kadash12/Altium-MPLAB-Senior/Beacon.jpg

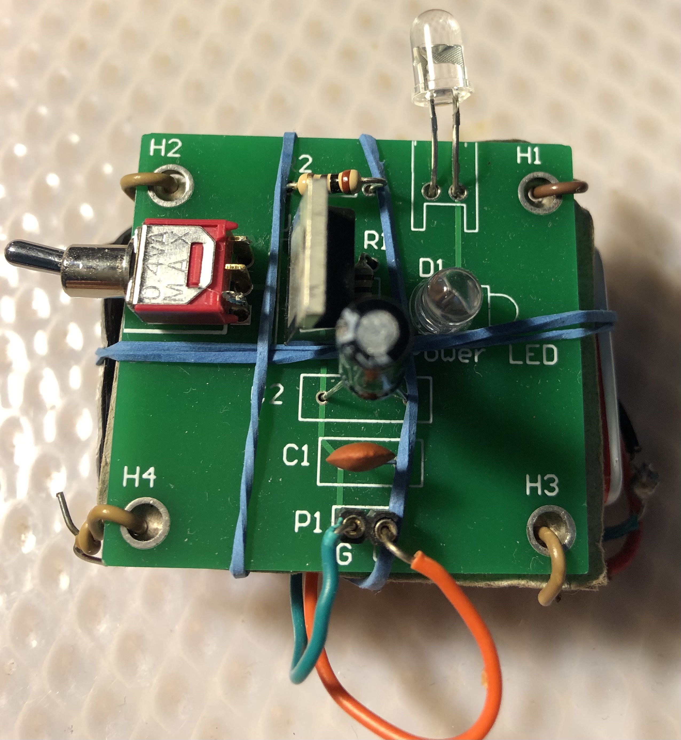
Beacon.jpg
