kadash12/Altium-MPLAB-Senior/L298N.jpg

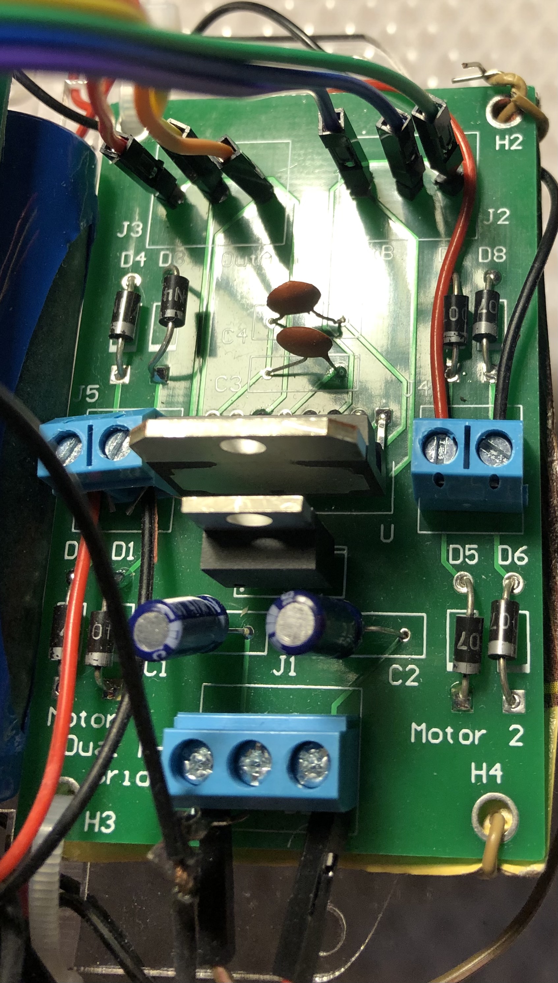
L298N.jpg
