kadash12/Altium-MPLAB-Senior/Project Presentation.pptx

## EEL 4914 Senior Design Project Presentation Title: Car Insight Submitted by: Johnny Li Advisory Engineer: Zane P Zudans

## Introduction

- Build a battery powered autonomous robotic car.
  - Platform for testing proximity detection and collision avoidance.
  - Use AI to solve a maze and then reverse to use the most optimal path back out.
- Problem: To ensure passenger and public safety in autonomous cars.
- What is out there already?
  - Integrated into many cars: Tesla, Waymo, and GM Cruise.
  - Vehicle sensors: Camera, Radar, and Lidar.
  - Ultrasonic sensors, traditionally associated with parking.
- LED, Speaker, Digital features (LCD, Timer)

## Project Description + Hardware

- Ultrasonic object detection
- Mount on servo to provide 180°
- Battery Power at ~5V
- LCD screen
- LEDs and speaker
- Gear motor to control movement
- PIC18F45Q10 Microcontroller:
  - 2 x I2C/SPI, 8-bit timer, PWM
Dual channel H bridge motor driver

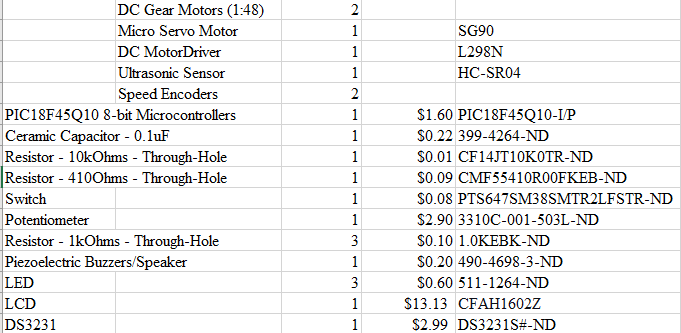
[picture p3: figure]
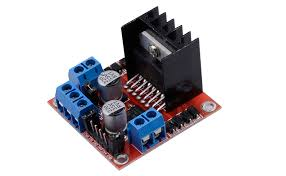
[picture p4: figure]
Qunqi L298N Motor Drive Controller Board Module Dual H Bridge DC Stepper For Arduino - - Amazon.com

HC-SR04

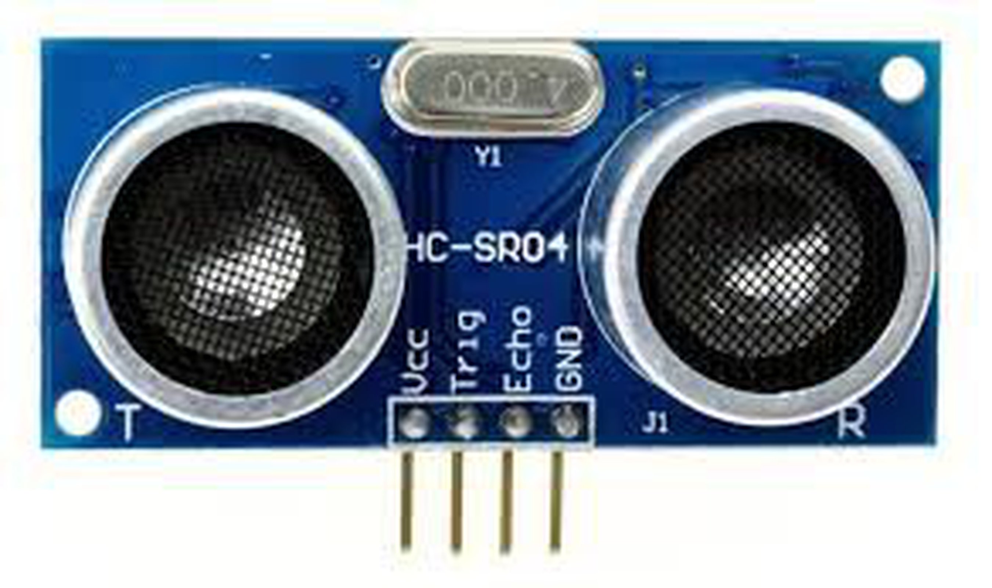
[picture p5: figure]
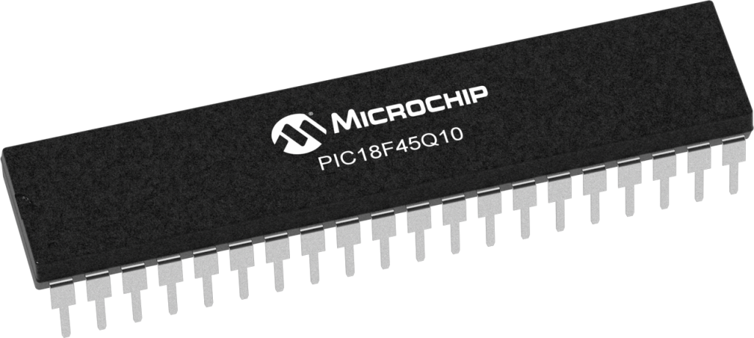
[picture p6: figure]

PIC18F45Q10

## Project hardware block diagram

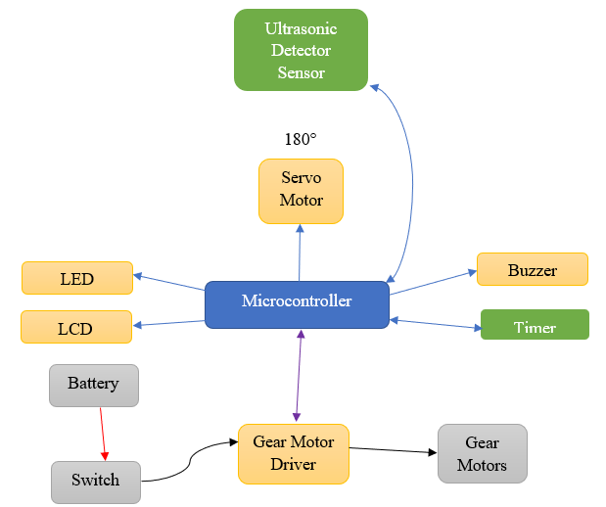
[picture p7: figure]

## Project software flow chart + Software

- Using MPLAB, write code in C.
1. Interfacing the ultrasonic detector to the microcontroller.
2. The microcontroller then calculates the distance.
3. The motor will be turned on for some time determined by AI.
  A. Reached the desired point or timeout to rescan forward.
  B. If an obstacle is detected it will move to avoid it.
4. Path taken by the car will be recorded. AI will then optimize the path back out the maze.
5. The microprocessor will control warning signals, scan time, and LCD output.

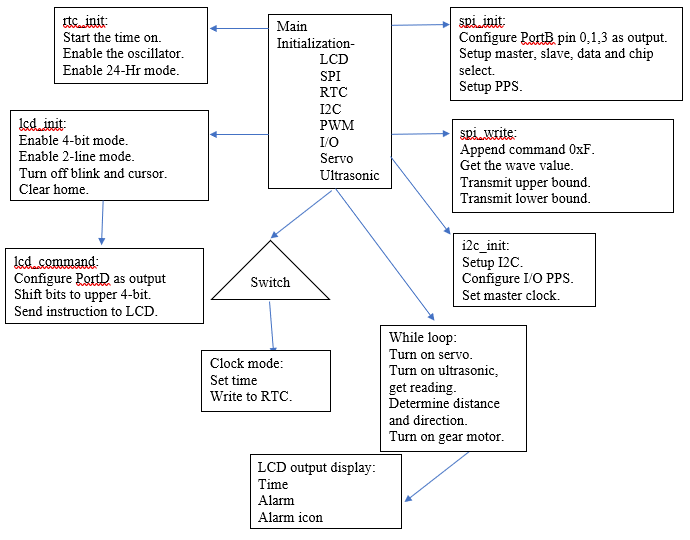
[picture p8: figure]

Object detected:
Turn left or right based on which side has the greatest amount of room.
Continue based on AI decision.

## Gantt Chart
