kadash12/Altium-MPLAB-Senior/Senior Design BOM.xlsx

Senior Design - Bill of Materials |  |  |  |  |  |  |  |  | Senior Design - Bill of Materials
Descripton |  | Quantity | Price/Part | Part Number |  |  | Price |  | Descripton |  | Quantity | Price/Part | Part Number |  |  | Price
Robot Car Chassis Kit |  | 1 | $23.33 | 2WD |  |  | $23.33 |  | Robot Car Chassis Kit |  | 1 | $23.33 | 2WD |  |  | $23.33
 | DC Gear Motors (1:48) | 2 |  |  |  |  | $0.00 |  |  | DC Gear Motors (1:48) | 2 |  |  |  |  | $0.00
 | Micro Servo Motor | 1 |  | SG90 |  |  | $0.00 |  |  | Micro Servo Motor | 1 |  | SG90 |  |  | $0.00
 | DC MotorDriver | 1 |  | L298N |  |  | $0.00 |  |  | DC MotorDriver | 1 |  | L298N |  |  | $0.00
 | Ultrasonic Sensor | 1 |  | HC-SR04 |  |  | $0.00 |  |  | Ultrasonic Sensor | 1 |  | HC-SR04 |  |  | $0.00
 | Speed Encoders | 2 |  |  |  |  | $0.00 |  |  | Speed Encoders | 2 |  |  |  |  | $0.00
 | Rocket Switch | 1 |  |  |  |  | $0.00 |  |  | Rocket Switch | 1 |  |  |  |  | $0.00
 | Wheels | 3 |  |  |  |  | $0.00 |  |  | Wheels | 3 |  |  |  |  | $0.00
 | Battery Case | 1 |  | 4x AA |  |  | $0.00 |  |  | Battery Case | 1 |  | 4x AA |  |  | $0.00
Battery Case |  | 1 | $5.29 | 4x AA |  |  | $5.29 |  | Recharable Battery 12V |  | 1 | $20.37 | TS2738 |  |  | $20.37
Battery Snap 9V |  | 1 | $0.49 | 232 |  |  | $0.49 |  | Battery Snap 9V |  | 1 | $0.49 | 232 |  |  | $0.49
IR Proximity Sensor |  | 2 | $1.20 |  |  |  | $2.40 |  | IR Proximity Sensor |  | 4 | $1.20 | MH-B |  |  | $4.79
IR Detector |  | 1 | $0.53 | QSD123 |  |  | $0.53 |  | Photodiode |  | 1 | $3.42 | BPW77NB |  |  | $3.42
IR Emitter |  | 1 | $0.75 | OP293B |  |  | $0.75 |  | IR Emitter |  | 2 | $0.75 | OP293B |  |  | $1.50
8-bit Microcontrollers |  | 1 | $1.60 | PIC18F45Q10-I/P |  |  | $1.60 |  | 8-bit Microcontrollers |  | 1 | $1.60 | PIC18F45Q10-I/P |  |  | $1.60
Ceramic Capacitor - 0.1uF |  | 1 | $0.22 | 399-4264-ND |  |  | $0.22 |  | Ceramic Capacitor - 0.1uF |  | 5 | $0.22 | 399-4264-ND |  |  | $1.10
Electrolytic Capacitors - 270uF |  | 1 | $0.36 | UPJ1A271MED1TD |  |  | $0.36 |  | Electrolytic Capacitors - 47uF |  | 4 | $0.24 | 493-17141-ND |  |  | $0.96
Resistor - 10k Ohms - Through-Hole |  | 1 | $0.01 | CF14JT10K0TR-ND |  |  | $0.01 |  | Resistor - 10k Ohms - Through-Hole |  | 2 | $0.01 | CF14JT10K0TR-ND |  |  | $0.02
Resistor - 410 Ohms - Through-Hole |  | 1 | $0.09 | CMF55410R00FKEB-ND |  |  | $0.09 |  | Resistor - 410 Ohms - Through-Hole |  | 1 | $0.09 | CMF55410R00FKEB-ND |  |  | $0.09
Resistor - 1k Ohms - Through-Hole |  | 4 | $0.10 | 1.0KEBK-ND |  |  | $0.40 |  | Resistor - 1k Ohms - Through-Hole |  | 4 | $0.10 | 1.0KEBK-ND |  |  | $0.40
Resistor - 10 Ohms - Through-Hole |  | 1 | $0.10 | MFR-25FBF52-10R |  |  | $0.10 |  | Resistor - 10 Ohms - Through-Hole |  | 2 | $0.10 | MFR-25FBF52-10R |  |  | $0.20
Resistor - 22k Ohms - Through-Hole |  | 1 | $0.31 | ROX1SJ22K |  |  | $0.31 |  | Resistor - 3.3k Ohms - Through-Hole |  | 2 | $0.31 | 3.3KZTR-ND |  |  | $0.62
Toggle Switch |  | 1 | $0.08 | PTS647SM38SMTR2LFSTR-ND |  |  | $0.08 |  | Toggle Switch |  | 2 | $0.08 | PTS647SM38SMTR2LFSTR-ND |  |  | $0.15
Potentiometer |  | 1 | $2.90 | 3310C-001-503L-ND |  |  | $2.90 |  | Potentiometer |  | 1 | $2.90 | 3310C-001-503L-ND |  |  | $2.90
Piezoelectric Buzzers/Speaker |  | 1 | $0.20 | 490-4698-3-ND |  |  | $0.20 |  | Piezoelectric Buzzers |  | 1 | $0.20 | 490-4698-3-ND |  |  | $0.20
LED |  | 3 | $0.60 | 511-1264-ND |  |  | $1.80 |  | LED |  | 4 | $0.60 | 511-1264-ND |  |  | $2.40
LCD |  | 1 | $13.13 | CFAH1602Z |  |  | $13.13 |  | LCD |  | 1 | $13.13 | CFAH1602Z |  |  | $13.13
LT1632 |  | 1 | $7.97 | LT1632CS8#PBF |  |  | $7.97 |  | Op Amp |  | 1 | $7.97 | LT1632CS8#PBF |  |  | $7.97
DS3231 |  | 1 | $2.99 | DS3231S#-ND |  |  | $2.99 |  | Timer |  | 1 | $2.99 | DS3231S#-ND |  |  | $2.99
LM2940CT |  | 1 | $2.14 | LM2940CT-5.0 |  |  | $2.14 |  | Voltage Regulator - 5V |  | 3 | $2.14 | LM2940CT-5.0 |  |  | $6.42
Assorted wire connectors |  | 1 | $6.29 | M to M, F to F, M to F |  |  | $6.29 |  | Terminal Block 3 |  | 1 | $0.42 | Screw Type 3 |  |  | $0.42
PCB Case |  | 1 | $12.85 |  |  |  | $12.85 |  | Terminal Block 2 |  | 2 | $0.32 | Screw Type 2 |  |  | $0.64
PCB Design x5 |  | 1 | $16.60 | 3 Panels |  |  | $16.60 |  | General Purpose Diode |  | 8 | $0.09 | 1N4007 |  |  | $0.72
 |  |  |  |  |  |  |  |  | Dual H-Bridge Driver |  | 1 | $9.72 | L298N |  |  | $9.72
Digikey 2 |  |  |  |  |  |  | $0.00 |  | Assorted wire connectors |  | 1 | $6.29 | M to M, F to F, M to F |  |  | $6.29
CAP ALUM 100UF 20% 6.3V RADIAL |  | 3 | $0.19 |  |  |  | $0.57
LED RED CLEAR 5MM ROUND T/H |  | 10 | $0.14 |  |  |  | $1.41 |  |  |  |  |  |  | Total | $112.85
RES 1K OHM 1/4W 5% AXIAL |  | 1 | $0.10 |  |  |  | $0.10
RES 10 OHM 1/4W 5% AXIAL |  | 3 | $0.10 |  |  |  | $0.30
IC REG LINEAR 5V 1A TO220-3 |  | 3 | $2.14 |  |  |  | $6.42
IC BRIDGE DRIVER PAR 15MULTIWATT |  | 1 | $9.72 |  |  |  | $9.72
DIODE GEN PURP 1KV 1A DO41 |  | 16 | $0.09 |  |  |  | $1.47
CAP ALUM 47UF 20% 16V RADIAL |  | 3 | $0.19 |  |  |  | $0.57
TERMINAL BLOCK, SCREW TYPE, 3 |  | 10 | $0.42 |  |  |  | $4.18
TERMINAL BLOCK, SCREW TYPE, 2 |  | 10 | $0.32 |  |  |  | $3.22
 |  |  |  |  | Total | $130.79
Soldering Station Holder |  | 1 | $16.37 |  |  |  |  | $16.37
Sodlering Iron |  | 1 | $15.99 |  |  |  |  | $15.99
IR Proximity Sensor |  | 3 | $1.20 |  |  |  |  | $3.59
Header Connectors |  | 1 | $11.69 |  |  |  |  | $11.69
Solder |  | 1 | $4.49 |  |  |  |  | $4.49
Tip Tinner |  | 1 | $8.35 |  |  |  |  | $8.35
Solder Tip |  | 1 | $9.07 |  |  |  |  | $9.07
Brass Wool and Tip Cleaner |  | 1 | $11.99 |  |  |  |  | $11.99
 |  |  |  |  | Full Total | $212.33
