kadash12/Altium-MPLAB-Senior/(list of files, drawings)

Other design files:
All/All.PrjPcb
All/all_pcb.PcbDoc
Car/Car.PrjPcb
Car/car.SchDoc
Car/car_pcb.PcbDoc
Dual_H-Bridge/Dual H.PcbDoc
Dual_H-Bridge/Dual_H-Bridge.PrjPcb
Dual_H-Bridge/Dual_H-Bridge.SchDoc
Senior_Design/PCB1.PcbDoc
