kadash12/Altium-MPLAB-Senior/Car.jpg

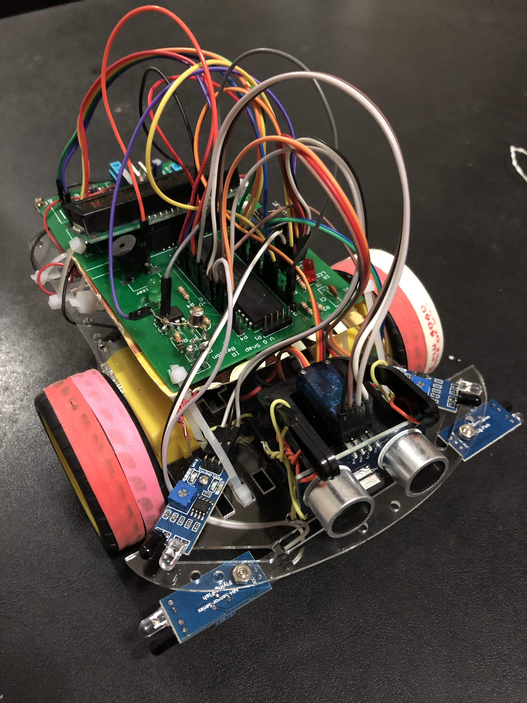
Car.jpg
